lbthomsen/i2c_led/README.md

# i2c_led

Page on the STM32World wiki: [https://stm32world.com/wiki/I2C_RGB_LED_Board](https://stm32world.com/wiki/I2C_RGB_LED_Board_Development)

Youtube playlist with all the live streams: https://www.youtube.com/playlist?list=PLVfOnriB1RjW1bjvfdfvBH_yly3bV6s8T
