lbthomsen/i2c_led/pcb/i2c_led_b_bom.csv

Reference | Value | Footprint | Qty | LCSC | Exclude from BOM
AD0,AD1 | SolderJumper_3_Bridged12 | Jumper:SolderJumper-3_P1.3mm_Bridged2Bar12_RoundedPad1.0x1.5mm | 2 |  | Excluded from BOM
C1,C3 | 1uF | Capacitor_SMD:C_0603_1608Metric | 2 | C15849
C2 | 100nF | Capacitor_SMD:C_0603_1608Metric | 1 | C14663
D1,D2,D3,D4,D5 | LED_RABG | i2c_led:RGB | 5 | C965840
J1 | Conn_01x05 | Connector_PinHeader_2.54mm:PinHeader_1x05_P2.54mm_Vertical | 1 |  | Excluded from BOM
R1,R2 | 4k7 | Resistor_SMD:R_0603_1608Metric | 2 | C23162
R3 | 10k | Resistor_SMD:R_0603_1608Metric | 1 | C25804
U1 | AW9523B | Package_DFN_QFN:QFN-24-1EP_4x4mm_P0.5mm_EP2.7x2.7mm | 1 | C148077
