lbthomsen/i2c_led/pcb/i2c_led.kicad_pcb

## KiCad design pcb/i2c_led.kicad_pcb (2025-06-23)

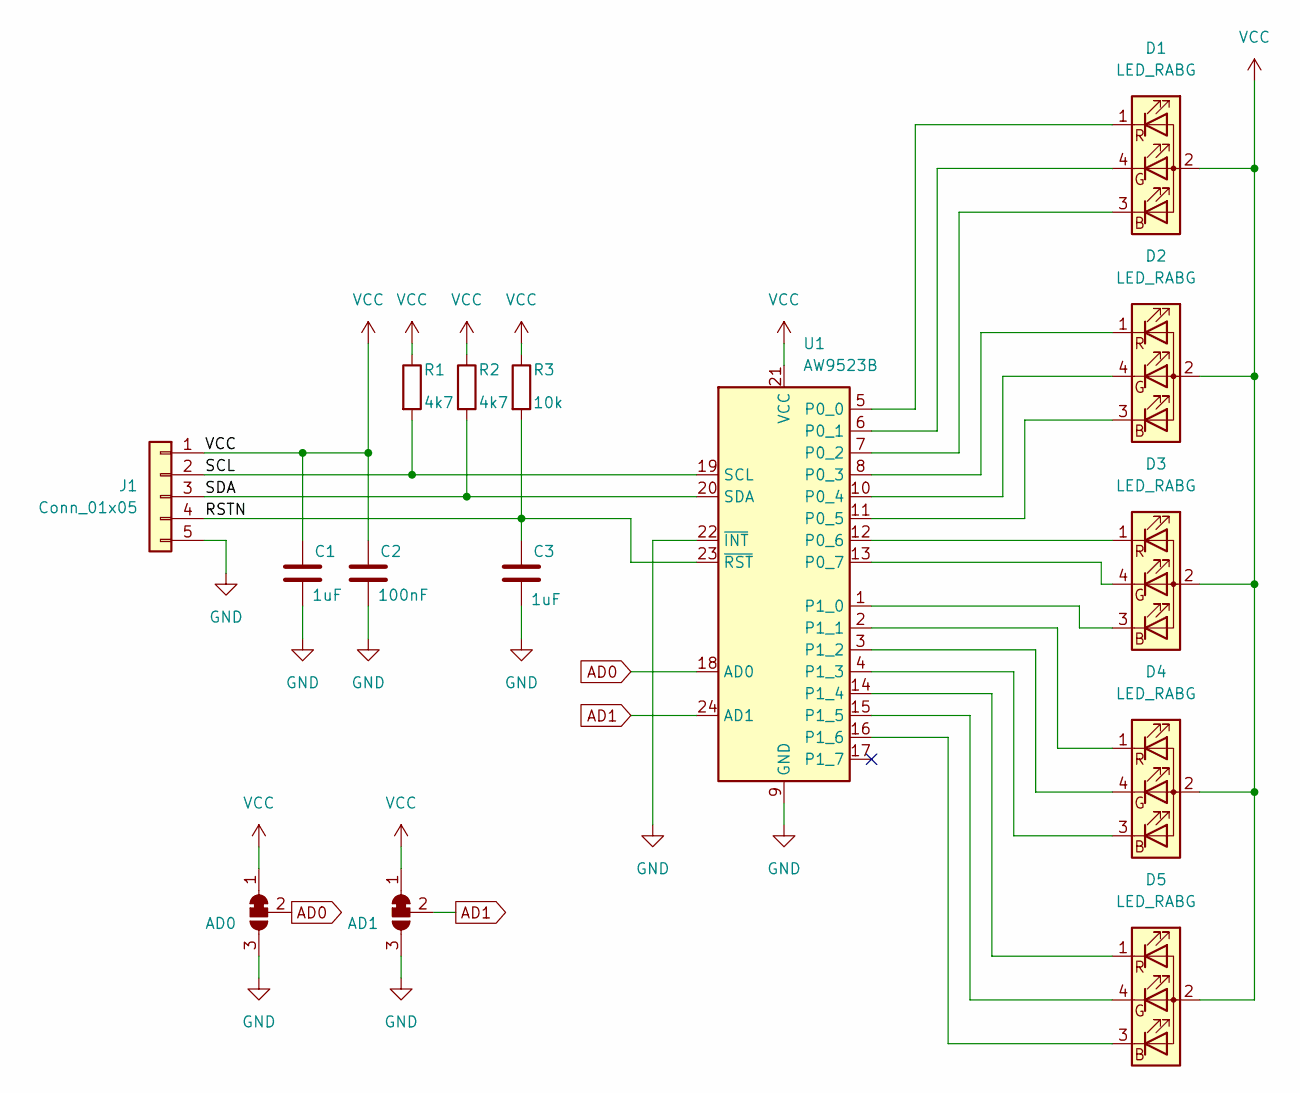
[picture p1: schematic i2c_led.kicad_sch, ${TITLE}]

Parts:
AD0, AD1: SolderJumper_3_Bridged12; SolderJumper-3_P1.3mm_Bridged2Bar12_RoundedPad1.0x1.5mm
C1, C3: 1uF; C_0603_1608Metric; LCSC C15849
C2: 100nF; C_0603_1608Metric; LCSC C14663
D1, D2, D3, D4, D5: LED_RABG; RGB; LCSC C965840
J1: Conn_01x05; PinHeader_1x05_P2.54mm_Vertical
R1, R2: 4k7; R_0603_1608Metric; LCSC C23162
R3: 10k; R_0603_1608Metric; LCSC C25804
U1: AW9523B; QFN-24-1EP_4x4mm_P0.5mm_EP2.7x2.7mm; LCSC C148077

Connections:
/RSTN: C3.1, J1.4, R3.2, U1.23 (~RST)
/SCL: J1.2, R1.2, U1.19 (SCL)
/SDA: J1.3, R2.2, U1.20 (SDA)
AD0: AD0.2 (C), U1.18 (AD0)
AD1: AD1.2 (C), U1.24 (AD1)
GND: AD0.3 (B), AD1.3 (B), C1.2, C2.2, C3.2, J1.5, U1.9 (GND), U1.22 (~INT), U1.25 (GND)
unnamed: D1.3 (BK), U1.7 (P0_2)
unnamed: D1.4 (GK), U1.6 (P0_1)
unnamed: D1.1 (RK), U1.5 (P0_0)
unnamed: D2.3 (BK), U1.11 (P0_5)
unnamed: D2.4 (GK), U1.10 (P0_4)
unnamed: D2.1 (RK), U1.8 (P0_3)
unnamed: D3.3 (BK), U1.1 (P1_0)
unnamed: D3.4 (GK), U1.13 (P0_7)
unnamed: D3.1 (RK), U1.12 (P0_6)
unnamed: D4.3 (BK), U1.4 (P1_3)
unnamed: D4.4 (GK), U1.3 (P1_2)
unnamed: D4.1 (RK), U1.2 (P1_1)
unnamed: D5.3 (BK), U1.16 (P1_6)
unnamed: D5.4 (GK), U1.15 (P1_5)
unnamed: D5.1 (RK), U1.14 (P1_4)
VCC: AD0.1 (A), AD1.1 (A), C1.1, C2.1, D1.2 (A), D2.2 (A), D3.2 (A), D4.2 (A), D5.2 (A), J1.1, R1.1, R2.1, R3.1, U1.21 (VCC)

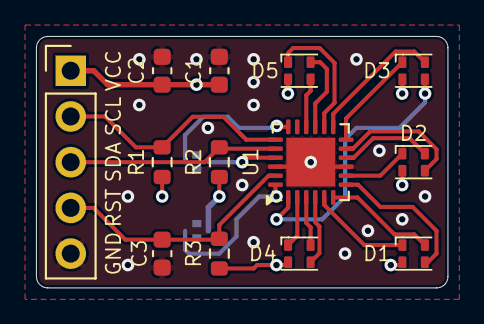
[picture p2: board i2c_led.kicad_pcb from above]

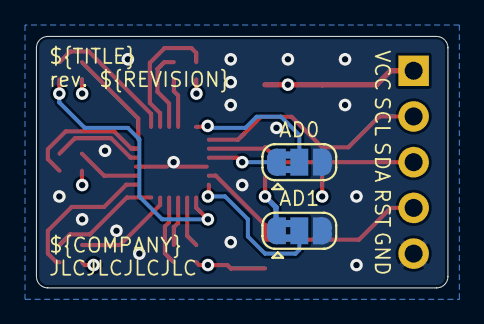
[picture p3: board i2c_led.kicad_pcb from below]

Board: 4 copper layers, 22.9 x 14.0 mm, 15 parts (2 on the bottom side), 22 nets.
