lbthomsen/i2c_led/fw/examples/stm32world_stm32f402/Core/Src/main.c

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
/* Includes ------------------------------------------------------------------*/
#include "main.h"

/* USER CODE BEGIN Includes */
#include <stdlib.h>
#include <stdio.h>
#include "aw9523.h"
#include "i2c_led.h"
#include "aw9523_led_demos.h"
/* USER CODE END Includes */

/* USER CODE BEGIN PD */
#define AW9523_ADDR AW9523_DEFAULT_ADDR
/* USER CODE END PD */

I2C_HandleTypeDef hi2c1;

UART_HandleTypeDef huart1;

/* USER CODE BEGIN PV */

AW9523_HandleTypeDef aw9523_handle;

//uint32_t tim_cnt;
//uint8_t update_leds;

/* USER CODE END PV */

void SystemClock_Config(void);
static void MX_GPIO_Init(void);
static void MX_I2C1_Init(void);
static void MX_USART1_UART_Init(void);
/* USER CODE BEGIN 0 */

// Send printf to uart1
int _write(int fd, char *ptr, int len) {
    HAL_StatusTypeDef hstatus;

    if (fd == 1 || fd == 2) {
        hstatus = HAL_UART_Transmit(&huart1, (uint8_t*) ptr, len, HAL_MAX_DELAY);
        if (hstatus == HAL_OK)
            return len;
        else
            return -1;
    }
    return -1;
}

/* USER CODE END 0 */

/**
  * @brief  The application entry point.
  * @retval int
  */
int main(void)
{

  /* MCU Configuration--------------------------------------------------------*/

  /* Reset of all peripherals, Initializes the Flash interface and the Systick. */
  HAL_Init();

  /* Configure the system clock */
  SystemClock_Config();

  /* Initialize all configured peripherals */
  MX_GPIO_Init();
  MX_I2C1_Init();
  MX_USART1_UART_Init();
  /* USER CODE BEGIN 2 */

    printf("\n\n\n\n--------\nStarting\n");

    HAL_Delay(10);

    printf("Scanning i2c bus\n");

    // Go through all possible i2c addresses
    for (uint8_t i = 0; i < 128; i++) {

        if (HAL_I2C_IsDeviceReady(&hi2c1, (uint16_t) (i << 1), 3, 5) == HAL_OK) {
            // We got an ack
            printf("%2x ", i);
        } else {
            printf("-- ");
        }

        if (i > 0 && (i + 1) % 16 == 0)
            printf("\n");

    }

    if (aw9523_init(&aw9523_handle, &hi2c1, AW9523_ADDR, AW9523_RST_GPIO_Port, AW9523_RST_Pin) != AW9523_Ok) {
        printf("Failed\n");
        Error_Handler();
    }

    // Initialize aw9523 in LED drive mode
    aw9523_write_register(&aw9523_handle, AW9523_CTL, 0x02); // set to 0x00, 0x01, 0x02 or 0x03 to limit max current per pin.
    aw9523_write_register(&aw9523_handle, AW9523_LP0, 0x00); // LED drive for P0
    aw9523_write_register(&aw9523_handle, AW9523_LP1, 0x00); // LED drive for P1

    //i2c_set_led(&aw9523_handle, 4, 10, 0, 10);

  /* USER CODE END 2 */

  /* Infinite loop */
  /* USER CODE BEGIN WHILE */

    uint32_t now = 0, next_blink = 500, next_tick = 1000, loop_cnt = 0, next_demo_tick = 0;

    while (1) {

        now = uwTick;

        if (now >= next_blink) {
            HAL_GPIO_TogglePin(LED_GPIO_Port, LED_Pin);
            next_blink = now + 500;
        }

        if (now >= next_tick) {
            printf("Tick %lu (loop=%lu)\n", now / 1000, loop_cnt);
            loop_cnt = 0;
            next_tick = now + 1000;
        }

        if (now >= next_demo_tick) {
            aw9523_led_demo_tick(&aw9523_handle);
            next_demo_tick = now + 10;
        }

        ++loop_cnt;

    /* USER CODE END WHILE */

    /* USER CODE BEGIN 3 */
    }
  /* USER CODE END 3 */
}

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
