lbthomsen/i2c_led/fw/examples/blackpill_stm32f411/blackpill_stm32f411.ioc

Mcu.UserName=STM32F411CEUx
PA0-WKUP.GPIO_Label=BTN
PA0-WKUP.Signal=GPXTI0
PA10.Signal=USART1_RX
PA13.Signal=SYS_JTMS-SWDIO
PA14.Signal=SYS_JTCK-SWCLK
PA9.Signal=USART1_TX
PB3.Signal=SYS_JTDO-SWO
PB4.GPIO_Label=INT
PB4.Signal=GPXTI4
PB5.GPIO_Label=RST
PB5.Signal=GPIO_Output
PB6.Signal=I2C1_SCL
PB7.Signal=I2C1_SDA
PC13-ANTI_TAMP.GPIO_Label=LED
PC13-ANTI_TAMP.Signal=GPIO_Output
