lbthomsen/i2c_led/fw/examples/stm32world_stm32f402/Core/Inc/main.h

#define LED_Pin GPIO_PIN_13
#define LED_GPIO_Port GPIOC
#define AW9523_RST_Pin GPIO_PIN_5
#define AW9523_RST_GPIO_Port GPIOB
