lbthomsen/i2c_led/(commit log)

2025-05-26 Project ongoing
    [i2c_led.kicad_pcb, i2c_led.kicad_sch]
2025-05-27 Done with second video https://youtube.com/live/dbczXZmWQ1s?feature=share
    [i2c_led.kicad_pcb, i2c_led.kicad_sch]
2025-05-27 Tweaked after review
    [i2c_led.kicad_pcb, i2c_led.kicad_sch]
2025-05-27 More tweaking
    [i2c_led-B_Cu.gbr, i2c_led-B_Mask.gbr, i2c_led-B_Paste.gbr, i2c_led-B_Silkscreen.gbr, i2c_led-Edge_Cuts.gbr, i2c_led-F_Cu.gbr, i2c_led-F_Mask.gbr, i2c_led-F_Paste.gbr]
2025-05-28 Working version
    [i2c_led-B_Cu.gbr, i2c_led-B_Mask.gbr, i2c_led-B_Paste.gbr, i2c_led-B_Silkscreen.gbr, i2c_led-Edge_Cuts.gbr, i2c_led-F_Cu.gbr, i2c_led-F_Mask.gbr, i2c_led-F_Paste.gbr]
2025-05-28 More tweaks - should be ready to order
    [i2c_led.kicad_pcb]
2025-05-30 Moving workstation
    [i2c_led.kicad_sch]
2025-05-30 Ready to order
    [i2c_led.kicad_pcb]
2025-06-12 Ready to order - rev_b
    [i2c_led-B_Cu.gbr, i2c_led-B_Mask.gbr, i2c_led-B_Paste.gbr, i2c_led-B_Silkscreen.gbr, i2c_led-Edge_Cuts.gbr, i2c_led-F_Cu.gbr, i2c_led-F_Mask.gbr, i2c_led-F_Paste.gbr]
2025-06-23 Added firmware - working
    [i2c_led.kicad_pcb]
2025-06-25 Created stm32f402 example
