lbthomsen/i2c_led/(notices)

Notices in the files:
fw/examples/stm32world_stm32f402/Core/Inc/main.h:
Copyright (c) 2025 STMicroelectronics.
All rights reserved.
